ORyomei/polishing-machine/software/README.md

# 研磨機 M5Stack 組み込みソフトウェア

```
このプロジェクトは VSCode に PlatformIO 拡張機能を入れて開発してください。
```

## 定数の変更
`src/config/constants.hpp` の中を見てください。
