ORyomei/polishing-machine/PCB/Project Outputs for PCB/ExportSTEP/polishing_machine.step

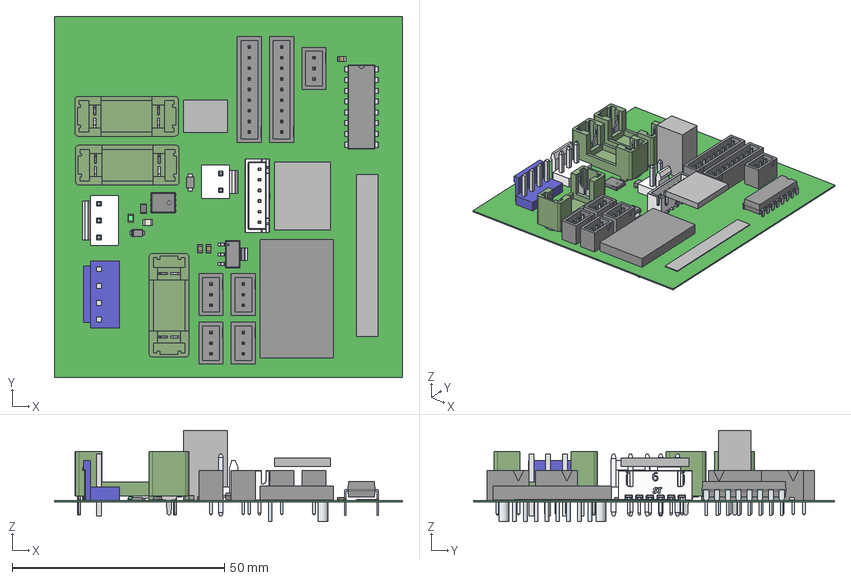
[picture p1: CAD file, 2025-02-20]
PCB/Project Outputs for PCB/ExportSTEP/polishing_machine.step
82.0 x 85.0 x 21.5 mm
Extruded x 6
LeadsArray x 7
Base
Crystal
Polarity Mark
Pads
Log
PinKIdent
PinK
PinA
Pins x 2
Package
Logo
Mid_Body
Mark
B2P-VH (LF)(SN)
User Library-B3P-VH_PinVH x 3
User Library-B3P-VH_B3P-body white
696108003002 - PTF_78 x 3
PinsArrayL
FilletPinR
B4P-VH
PinsArrayLR
Leads x 12
