ORyomei/polishing-machine/PCB/Project Outputs for PCB/Job1.PDF

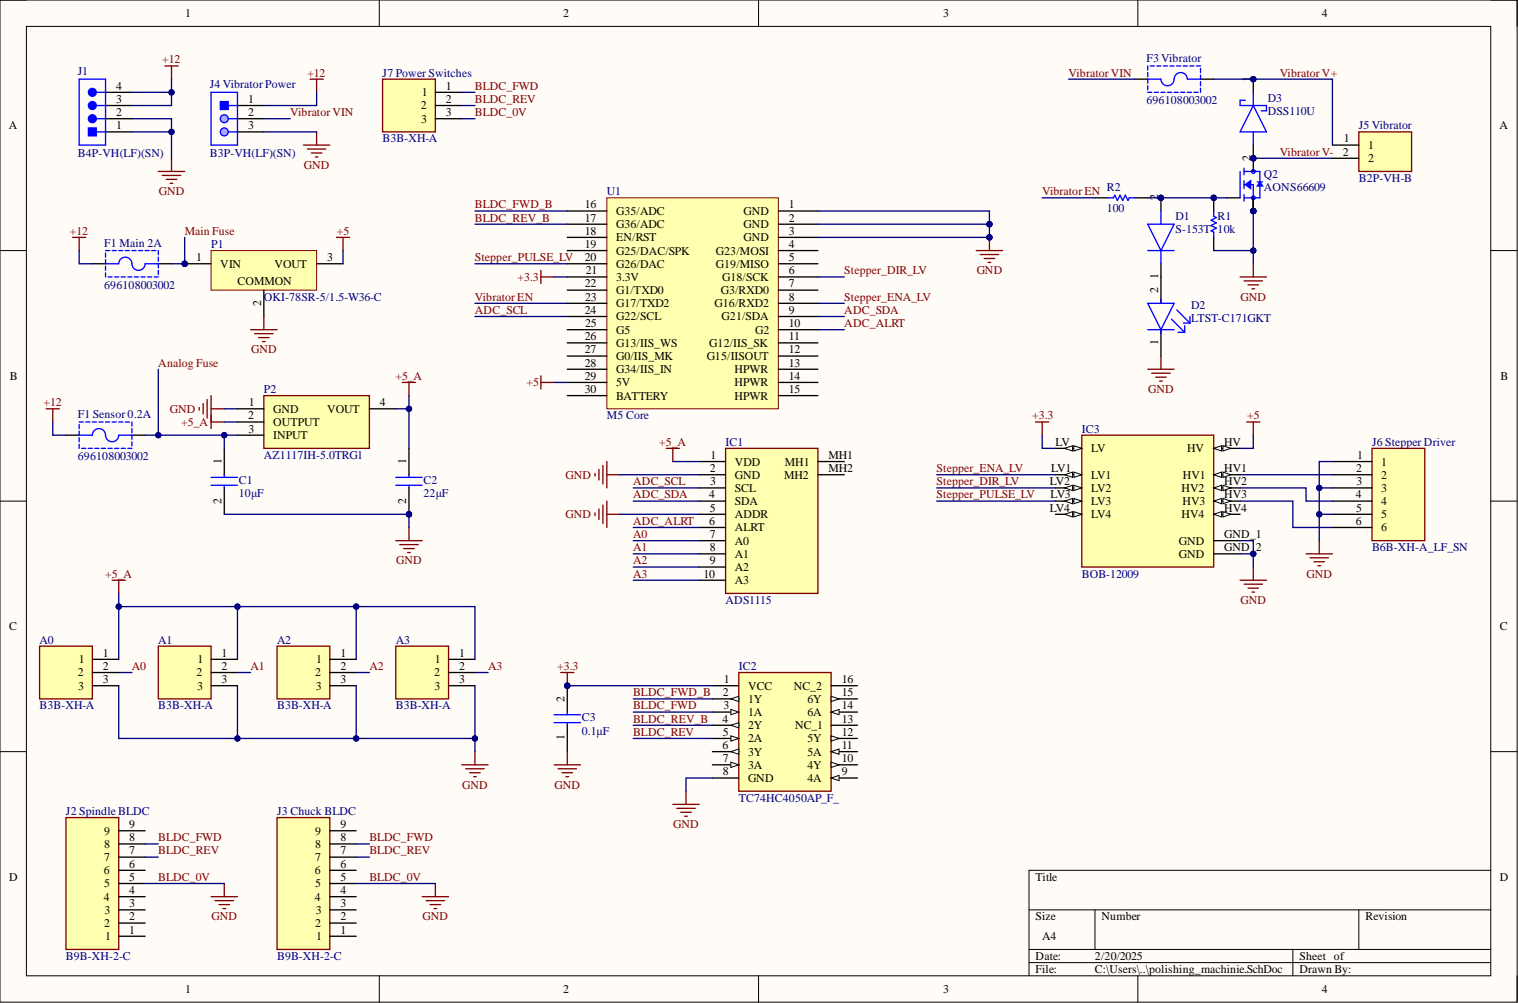
[picture p2: page 1]

2 | 2 3

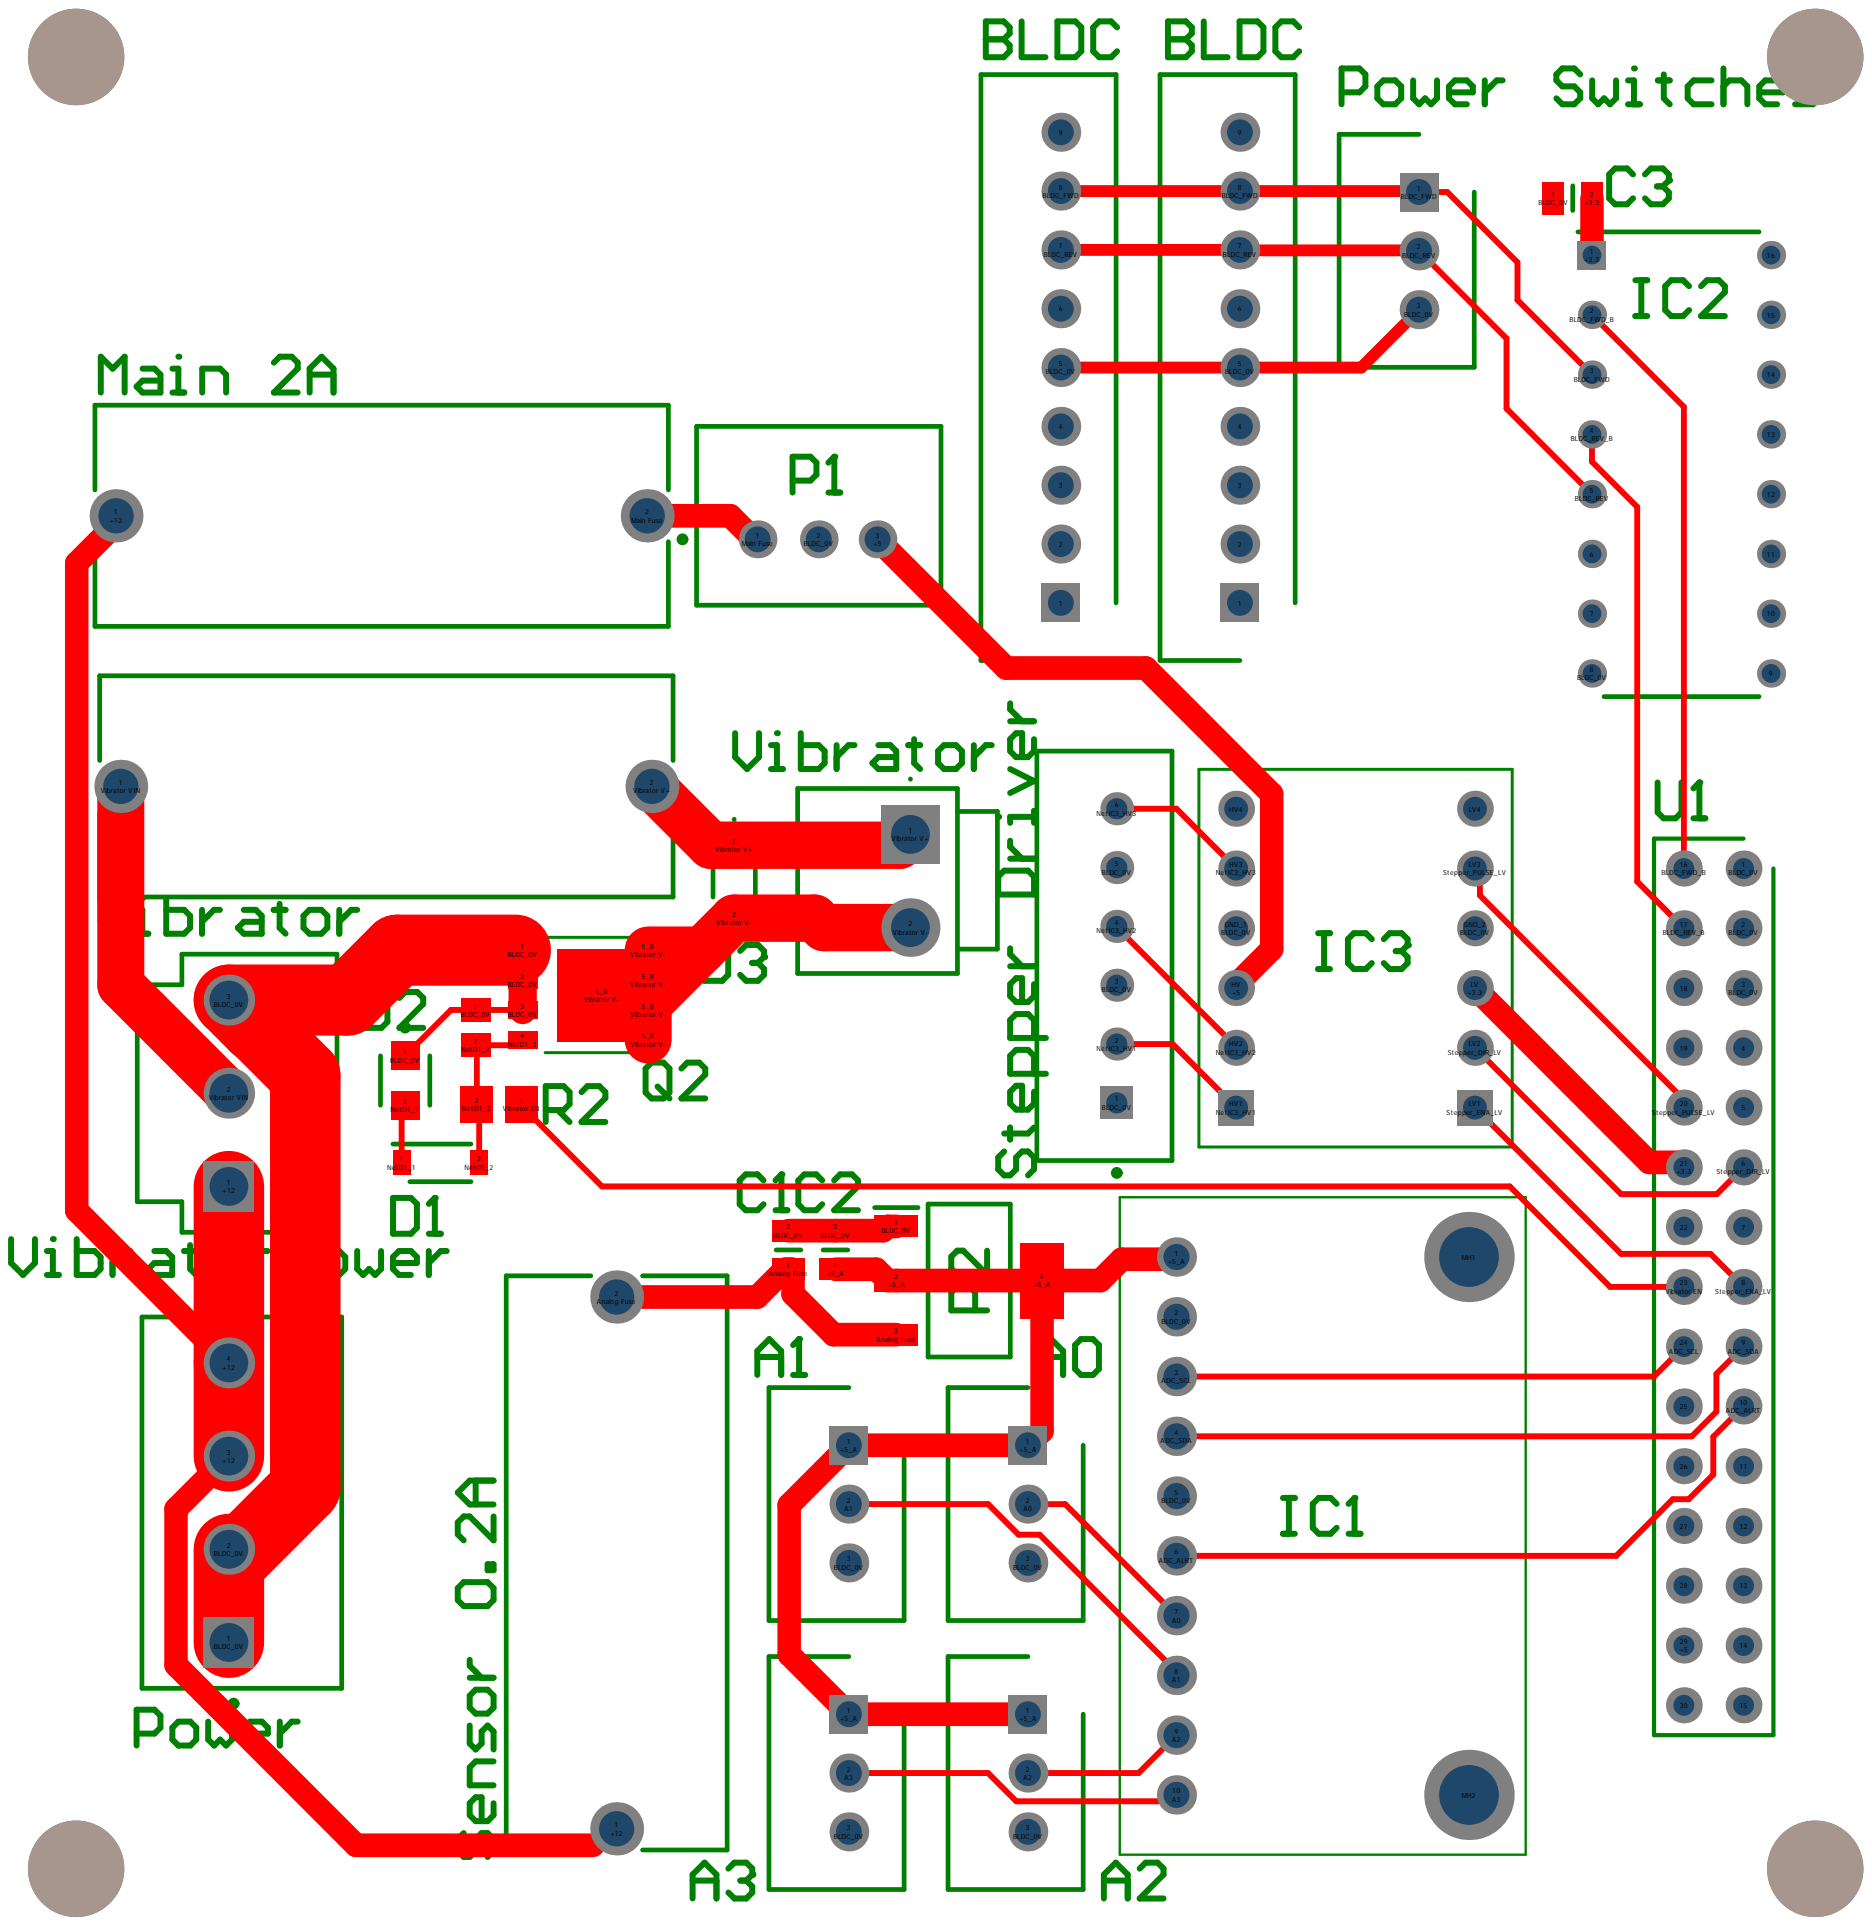
[picture p3: page 2]

1 BLDC_0V | | 5_8

5_8 | Vibrator V-

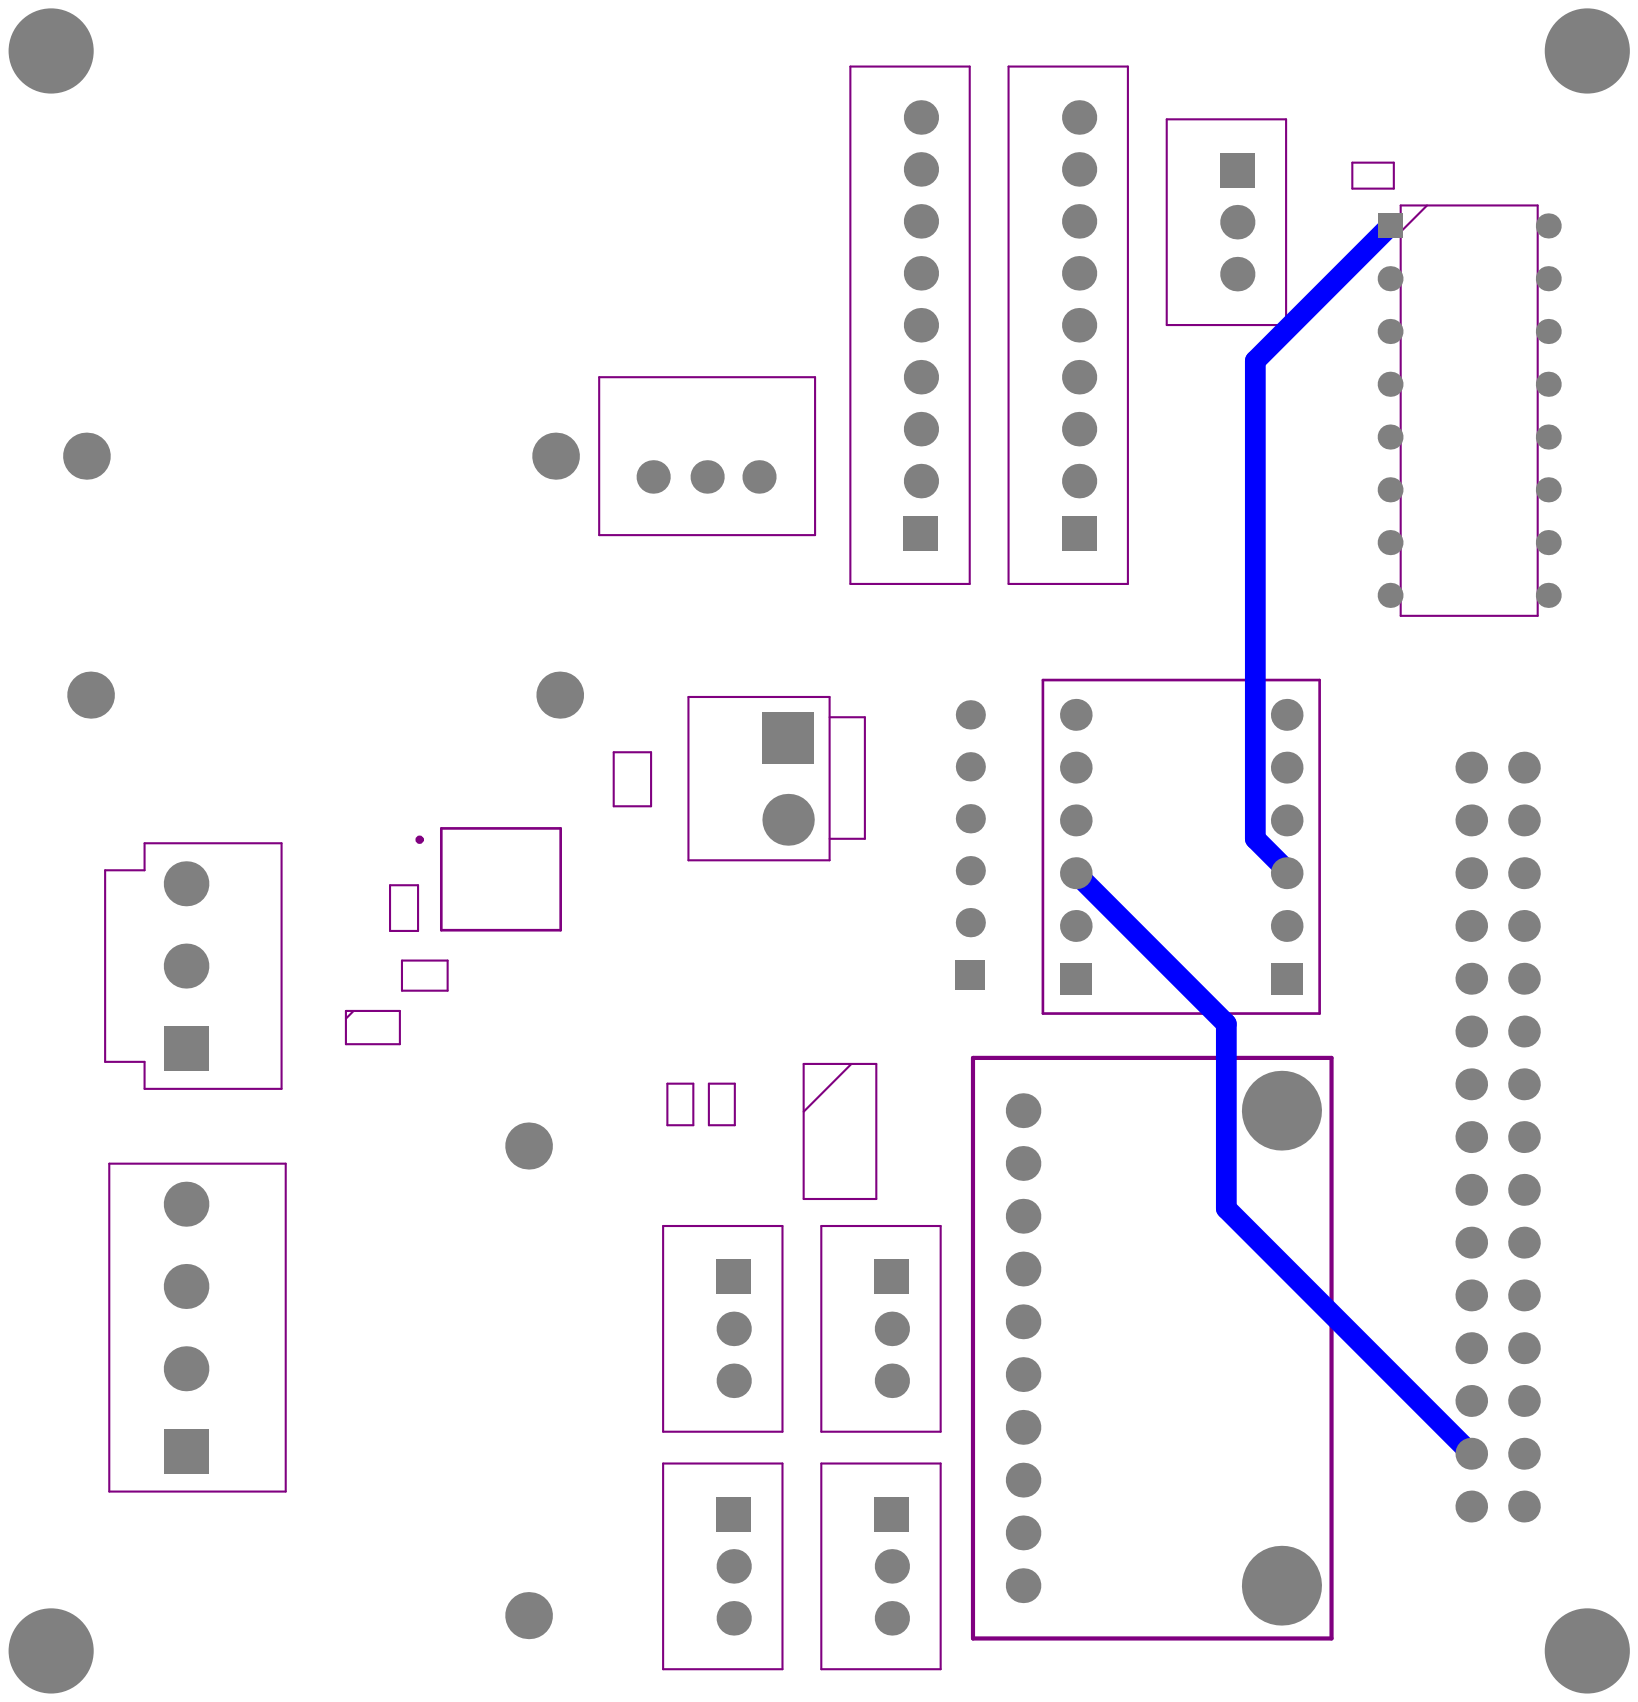
[picture p4: page 3]

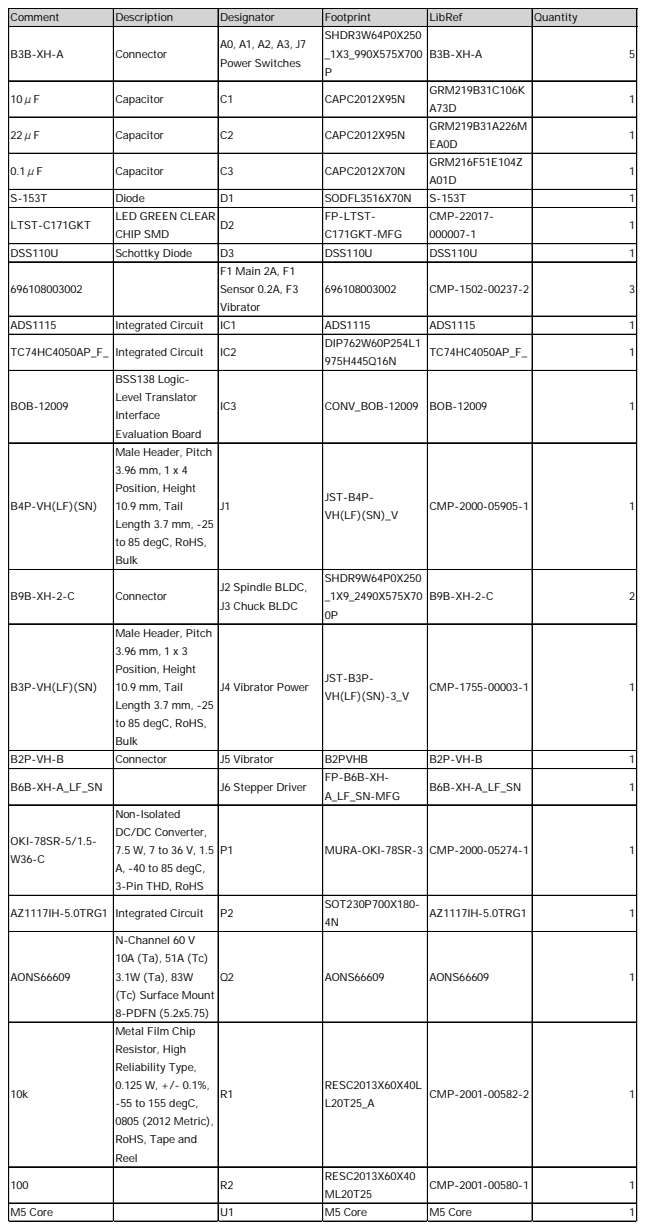
[picture p5: page 4]

Comment | Description | Designator | Footprint | LibRef | Quantity
B3B-XH-A | Connector | A0, A1, A2, A3, J7 Power Switches | SHDR3W64P0X250 _1X3_990X575X700 P | B3B-XH-A | 5

10μF | Capacitor | C1 | CAPC2012X95N | GRM219B31C106K A73D | 1

22μF | Capacitor | C2 | CAPC2012X95N | GRM219B31A226M EA0D | 1

0.1μF | Capacitor | C3 | CAPC2012X70N | GRM216F51E104Z A01D | 1

S-153T | Diode | D1 | SODFL3516X70N | S-153T | 1
LTST-C171GKT | LED GREEN CLEAR CHIP SMD | D2 | FP-LTST-C171GKT-MFG | CMP-22017-000007-1 | 1

DSS110U | Schottky Diode | D3 | DSS110U | DSS110U | 1
696108003002 | | F1 Main 2A, F1 Sensor 0.2A, F3 Vibrator | 696108003002 | CMP-1502-00237-2 | 3

ADS1115 | Integrated Circuit | IC1 | ADS1115 | ADS1115 | 1
TC74HC4050AP_F_ | Integrated Circuit | IC2 | DIP762W60P254L1 975H445Q16N | TC74HC4050AP_F_ | 1

BOB-12009 | BSS138 Logic-Level Translator Interface Evaluation Board | IC3 | CONV_BOB-12009 | BOB-12009 | 1

B4P-VH(LF)(SN) | Male Header, Pitch 3.96 mm, 1 x 4 Position, Height 10.9 mm, Tail Length 3.7 mm, -25 to 85 degC, RoHS, Bulk | J1 | JST-B4P-VH(LF)(SN)_V | CMP-2000-05905-1 | 1

B9B-XH-2-C | Connector | J2 Spindle BLDC, J3 Chuck BLDC | SHDR9W64P0X250 _1X9_2490X575X70 0P | B9B-XH-2-C | 2

B3P-VH(LF)(SN) | Male Header, Pitch 3.96 mm, 1 x 3 Position, Height 10.9 mm, Tail Length 3.7 mm, -25 to 85 degC, RoHS, Bulk | J4 Vibrator Power | JST-B3P-VH(LF)(SN)-3_V | CMP-1755-00003-1 | 1

B2P-VH-B | Connector | J5 Vibrator | B2PVHB | B2P-VH-B | 1
B6B-XH-A_LF_SN | | J6 Stepper Driver | FP-B6B-XH-A_LF_SN-MFG | B6B-XH-A_LF_SN | 1

OKI-78SR-5/1.5-W36-C | Non-Isolated DC/DC Converter, 7.5 W, 7 to 36 V, 1.5 A, -40 to 85 degC, 3-Pin THD, RoHS | P1 | MURA-OKI-78SR-3 | CMP-2000-05274-1 | 1

AZ1117IH-5.0TRG1 | Integrated Circuit | P2 | SOT230P700X180-4N | AZ1117IH-5.0TRG1 | 1

AONS66609 | N-Channel 60 V 10A (Ta), 51A (Tc) 3.1W (Ta), 83W (Tc) Surface Mount 8-PDFN (5.2x5.75) | Q2 | AONS66609 | AONS66609 | 1

10k | Metal Film Chip Resistor, High Reliability Type, 0.125 W, +/- 0.1%, -55 to 155 degC, 0805 (2012 Metric), RoHS, Tape and Reel | R1 | RESC2013X60X40L L20T25_A | CMP-2001-00582-2 | 1

100 | | R2 | RESC2013X60X40 ML20T25 | CMP-2001-00580-1 | 1

M5 Core | | U1 | M5 Core | M5 Core | 1
