ORyomei/polishing-machine/(list of files, drawings)

Other design files:
PCB/PCB.PrjPcb
PCB/polishing_machine.PcbDoc
PCB/polishing_machine.PcbLib
PCB/polishing_machine.SchLib
PCB/polishing_machinie.SchDoc
