ORyomei/polishing-machine/software/src/switch/switch.hpp

#ifndef _SWITCH_H_
#define _SWITCH_H_
#include <Arduino.h>
#include "config/constants.hpp"
#include "motor/motor_state.hpp"

#define SWITCH_DURATION 50 // ms

class ToggleSwitch // プルアップピン（通常HIGHでGNDと繋がってLOWになる）を使う想定のスイッチのクラス
{
public:
    ToggleSwitch(uint8_t pin);
    void initialize();
    void read();
    bool isOn();
    bool switched();
    bool switchedToOff();
    bool switchedToOn();

private:
    const uint8_t pin;
    const uint32_t duration = SWITCH_DURATION;
    const uint8_t onState = LOW;
    bool _isOn;
    bool _switched;
    uint8_t state = !onState;     // current button state
    uint8_t lastState = !onState; // previous button state
    uint32_t time = 0;            // time of current state (all times are in ms)
    uint32_t lastTime = 0;        // time of previous state
    uint32_t lastChange = 0;      // time of last state change
};

class MotorSwitch
{
public:
    MotorSwitch(uint8_t fwdPin = BLDC_FWD_PIN, uint8_t revPin = BLDC_REV_PIN);
    void initialize();
    void read();
    bool changed();
    MotorSwitchState getState();

private:
    ToggleSwitch fwdToggleSwitch, revToggleSwitch;
};

#endif
