ORyomei/polishing-machine/software/src/config/configurator.hpp

#ifndef _CONFIGURATOR_H_
#define _CONFIGURATOR_H_

#include <Arduino.h>
#include "flash.hpp"
#include "motor/motor_controller.hpp"
#include "sensor/sensor.hpp"
#include <utility/Button.h>
#include <utility/Config.h>
#include <ArduinoJson.h>

#define UPPER_LOWER_POSITION_FILE_NAME "/upper_lower_position.txt"

#define CONFIGURATOR_CYCLE_TIME 23

struct Config
{
public:
    virtual bool loadFromJsonStr(const char *jsonStr);
    virtual void loadFromConstants();
    virtual const char *toJsonStr();
};

struct UpperLowerPositionConfig : Config
{
    double upperPosition;
    double lowerPosition;
    bool loadFromJsonStr(const char *jsonStr);
    void loadFromConstants();
    const char *toJsonStr();
    void copyFrom(UpperLowerPositionConfig &config);
};

class Configurator
{
public:
    Configurator(MotorController &motorController, Sensor &sensor);
    void initialize();
    void loadUpperLowerPositionFromFlash();
    void calibrateFromflash();
    void enable();
    void disable();
    void saveAndDisable();
    bool enabled();
    void setCurrentPositionUpper();
    void setCurrentPositionLower();

    void start();
    void stop();
    void run();
    void cycle();

private:
    Flash flash;
    MotorController &motorController;
    Sensor &sensor;
    UpperLowerPositionConfig upperLowerPositionConfig;     // 通常の設定値
    UpperLowerPositionConfig upperLowerPositionConfigTemp; // コンフィギュレーション時に一時的に設定値を保持する
    // Button buttonA = Button(BUTTON_A_PIN, true, 50);
    Button buttonB = Button(BUTTON_B_PIN, true, 50);
    Button buttonC = Button(BUTTON_C_PIN, true, 50);
    // TODO コンフィグレーション中はモーターを止めるようにする
    TaskHandle_t taskHandle;
    bool _enabled = false;
    void calibrate();
};

void runConfigurator(void *configurator);

#endif
