ORyomei/polishing-machine/software/src/ui/out_of_range_screen.cpp

#include "out_of_range_screen.hpp"

OutOfRangeScreen::OutOfRangeScreen(M5Display &lcd, Sensor &sensor)
    : Screen(lcd), sensor(sensor)
{
}

void OutOfRangeScreen::draw()
{
    // setColor(WHITE, RED);
    setColor(WHITE, ORANGE);
    lcd.setTextSize(4);
    lcd.setCursor(0, 0);
    lcd.print("OUT OF RANGE !!");

    lcd.setTextSize(4);
    lcd.setCursor(0, 40);
    lcd.print("h:         mm");
    lcd.setTextSize(3);
    lcd.setCursor(0, 110);
    lcd.printf("Heigt must be within %5.2f - %5.2f mm", sensor.getLowerLimit(), sensor.getUpperLimit());
}

void OutOfRangeScreen::update()
{
    lcd.setCursor(80, 40);
    lcd.setTextSize(4);
    lcd.printf("%6.2lf", sensor.convertedValue());
}
