ORyomei/polishing-machine/(commit log)

2025-01-09 solenoid controllerを実装
2025-02-05 ディレクトリ構成変更
2025-02-20 add pcb
    [PCB.PrjPcb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]
2025-02-21 往復するだけ
2025-02-24 外部入力でモーターをコントロール(WIP)
2025-02-24 外部入力でモーターをコントロール
2025-02-26 制御部分修正
2025-02-28 LCDのバグあり
2025-03-01 StepperライブラリのDriverモードを修正
2025-03-01 モーター制御の定数を変更
2025-03-01 サイクルタイムを設定
2025-03-01 UI追加
2025-03-02 設定ファイルを追加（自動生成）
2025-03-02 マシンの状態を管理するクラスを追加
2025-03-02 Vibratorを追加
2025-03-02 状態遷移を修正
2025-03-02 制御パラメータを修正
2025-03-02 UIの更新頻度を落とす
2025-03-02 定数を変更
2025-03-06 UIを修正
2025-03-06 UI色変更
2025-03-06 Sensor_Lower_Limit調整
2025-03-06 定数を全てconstants.hppに移動
